stailus/SI4684-DAB-Receiver/Kicad/Mainboard SMD/SI4684 SMD.kicad_pcb

## KiCad design Kicad/Mainboard SMD/SI4684 SMD.kicad_pcb (2025-07-09)

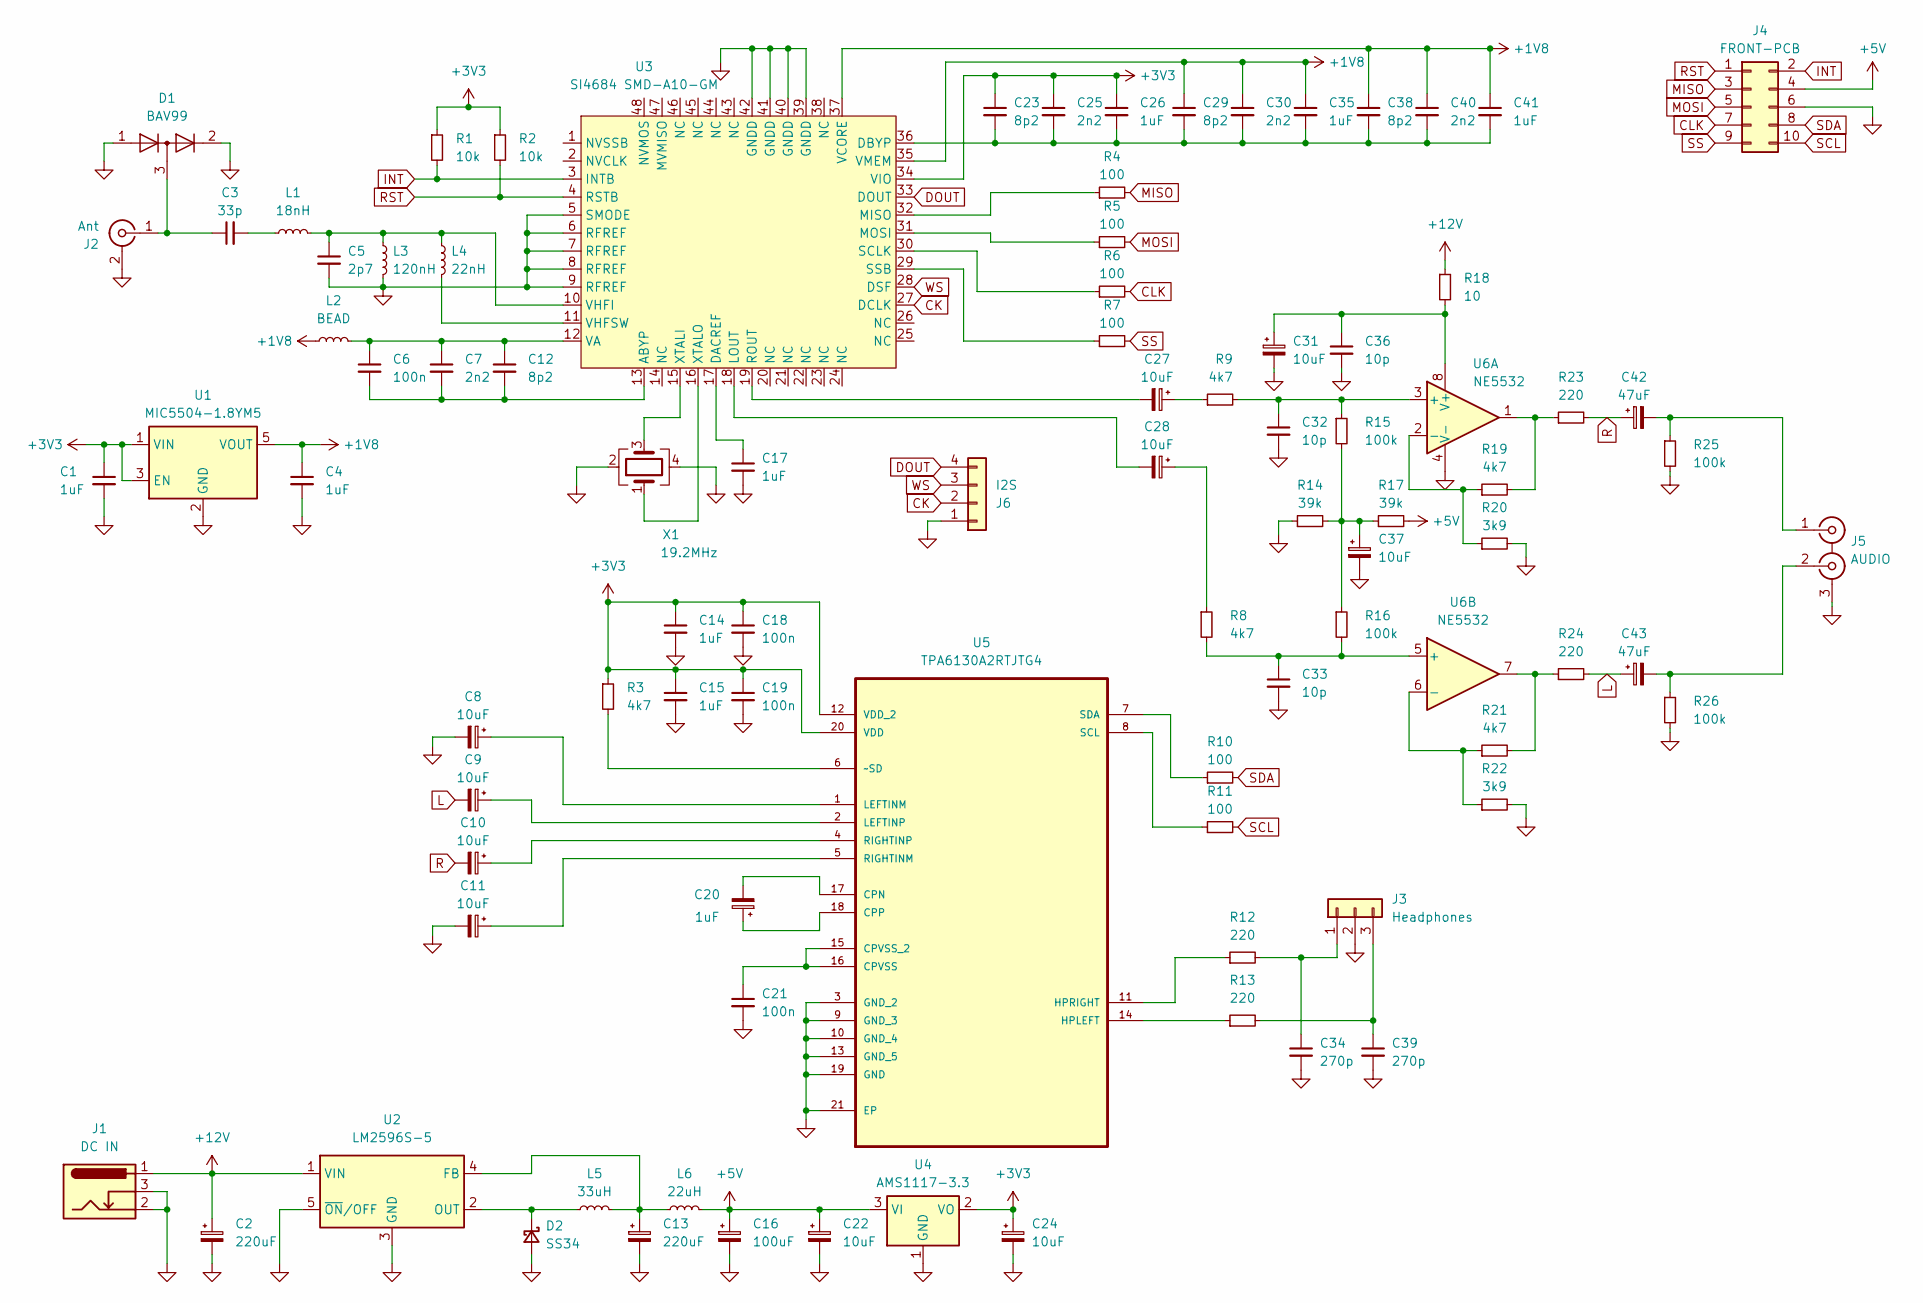
[picture p1: schematic SI4684 SMD.kicad_sch, SI4684 SMD DAB ontvanger]

Parts:
C1, C4, C14, C15, C17, C26, C35, C41: 1uF; C_0603_1608Metric
C2, C13: 220uF; CP_Elec_6.3x7.7
C3: 33p; C_0603_1608Metric
C5: 2p7; C_0603_1608Metric
C6, C18, C19, C21: 100n; C_0603_1608Metric
C7, C25, C30, C40: 2n2; C_0603_1608Metric
C8, C9, C10, C11, C22, C24, C27, C28, C31, C37: 10uF; CP_Elec_4x5.4
C12, C23, C29, C38: 8p2; C_0603_1608Metric
C16: 100uF; CP_Elec_6.3x7.7
C20: 1uF; CP_Elec_4x5.4
C32, C33, C36: 10p; C_0603_1608Metric
C34, C39: 270p; C_0603_1608Metric
C42, C43: 47uF; CP_Elec_6.3x5.4
D1: BAV99; SOT-23
D2: SS34; D_SMB
J1: DC IN; BarrelJack_Horizontal
J2: Ant; SMA_Amphenol_132134-16_Vertical
J3: Headphones; JST_PH_B3B-PH-K_1x03_P2.00mm_Vertical
J4: FRONT-PCB; IDC-Header_2x05_P2.54mm_Vertical
J5: AUDIO; FC68405_cinch
J6: I2S; PinHeader_1x04_P2.54mm_Vertical
L1: 18nH; L_0603_1608Metric
L2: BEAD; L_0603_1608Metric
L3: 120nH; L_0603_1608Metric
L4: 22nH; L_0603_1608Metric
L5: 33uH; L_TracoPower_TCK-047_5.2x5.8mm
L6: 22uH; L_TracoPower_TCK-047_5.2x5.8mm
R1, R2: 10k; R_0603_1608Metric
R3, R8, R9, R19, R21: 4k7; R_0603_1608Metric
R4, R5, R6, R7, R10, R11: 100; R_0603_1608Metric
R12, R13, R23, R24: 220; R_0603_1608Metric
R14, R17: 39k; R_0603_1608Metric
R15, R16, R25, R26: 100k; R_0603_1608Metric
R18: 10; R_0603_1608Metric
R20, R22: 3k9; R_0603_1608Metric
U1: MIC5504-1.8YM5; SOT-23-5
U2: LM2596S-5; TO-263-5_TabPin3
U3: SI4684 SMD-A10-GM; QFN-48-1EP_7x7mm_P0.5mm_EP5.3x5.3mm
U4: AMS1117-3.3; SOT-223-3_TabPin2
U5: TPA6130A2RTJTG4; QFN-20-1EP_4x4mm_P0.5mm_EP2.7x2.7mm; MPN TPA6130A2RTJTG4
U6: NE5532; SOIC-8_3.9x4.9mm_P1.27mm
X1: 19.2MHz; Crystal_SMD_3225-4Pin_3.2x2.5mm

Connections:
+1V8: C4.1, C29.1, C30.1, C35.1, C38.1, C40.1, C41.1, L2.1, U1.5 (VOUT), U3.35 (VMEM), U3.37 (VCORE)
+3V3: C1.1, C14.1, C15.1, C18.1, C19.1, C23.1, C24.1, C25.1, C26.1, R1.1, R2.1, R3.1, U1.1 (VIN), U1.3 (EN), U3.34 (VIO), U4.2 (VO), U5.12 (VDD_2), U5.20 (VDD)
+5V: C16.1, C22.1, J4.4, L6.2, R17.2, U4.3 (VI)
+12V: C2.1, J1.1, R18.1, U2.1 (VIN)
CK: J6.2, U3.27 (DCLK)
CLK: J4.7, R6.2
DOUT: J6.4, U3.33 (DOUT)
GND: C1.2, C2.2, C4.2, C5.2, C8.2, C11.2, C13.2, C14.2, C15.2, C16.2, C17.2, C18.2, C19.2, C21.2, C22.2, C24.2, C31.2, C32.2, C33.2, C34.2, C36.2, C37.2, C39.2, D1.1 (K), D1.2 (A), D2.2 (A), J1.2, J1.3, J2.2 (Ext), J3.2, J4.6, J5.3 (EXT), J6.1, L3.2, R14.1, R20.2, R22.2, R25.2, R26.2, U1.2 (GND), U2.3 (GND), U2.5 (~ON/OFF), U3.5 (SMODE), U3.6 (RFREF), U3.7 (RFREF), U3.8 (RFREF), U3.9 (RFREF), U3.39 (GNDD), U3.40 (GNDD), U3.41 (GNDD), U3.42 (GNDD), U3.49 (GND), U4.1 (GND), U5.3 (GND_2), U5.9 (GND_3), U5.10 (GND_4), U5.13 (GND_5), U5.19 (GND), U5.21 (EP), U6.4 (V-), X1.2, X1.4
INT: J4.2, R1.2, U3.3 (INTB)
L: C9.2, C43.1, R24.2
MISO: J4.3, R4.2
MOSI: J4.5, R5.2
unnamed: C3.2, L1.1
unnamed: C27.1, R9.1
unnamed: C28.1, R8.1
unnamed: C37.1, R14.2, R15.2, R16.1, R17.1
unnamed: D2.1 (K), L5.1, U2.2 (OUT)
unnamed: C3.1, D1.3 (K), J2.1 (In)
unnamed: C34.1, J3.1, R12.2
unnamed: C39.1, J3.3, R13.2
unnamed: C42.2, J5.1 (IN1), R25.1
unnamed: C43.2, J5.2 (IN2), R26.1
unnamed: R19.2, R23.1, U6.1
unnamed: R21.2, R24.1, U6.7
unnamed: C13.1, L5.2, L6.1, U2.4 (FB)
unnamed: C6.2, C7.2, C12.2, U3.13 (ABYP)
unnamed: C17.1, U3.17 (DACREF)
unnamed: C23.2, C25.2, C26.2, C29.2, C30.2, C35.2, C38.2, C40.2, C41.2, U3.36 (DBYP)
unnamed: C28.2, U3.18 (LOUT)
unnamed: R4.1, U3.32 (MISO)
unnamed: R5.1, U3.31 (MOSI)
unnamed: C27.2, U3.19 (ROUT)
unnamed: R6.1, U3.30 (SCLK)
unnamed: R7.1, U3.29 (SSB)
unnamed: C6.1, C7.1, C12.1, L2.2, U3.12 (VA)
unnamed: C5.1, L1.2, L3.1, L4.1, U3.10 (VHFI)
unnamed: L4.2, U3.11 (VHFSW)
unnamed: U3.15 (XTALI), X1.3
unnamed: U3.16 (XTALO), X1.1
unnamed: C20.2, U5.17 (CPN)
unnamed: C20.1, U5.18 (CPP)
unnamed: C21.1, U5.15 (CPVSS_2), U5.16 (CPVSS)
unnamed: R13.1, U5.14 (HPLEFT)
unnamed: R12.1, U5.11 (HPRIGHT)
unnamed: C8.1, U5.1 (LEFTINM)
unnamed: C9.1, U5.2 (LEFTINP)
unnamed: C11.1, U5.5 (RIGHTINM)
unnamed: C10.1, U5.4 (RIGHTINP)
unnamed: R11.1, U5.8 (SCL)
unnamed: R10.1, U5.7 (SDA)
unnamed: R3.2, U5.6 (~SD)
unnamed: C32.1, R9.2, R15.1, U6.3 (+)
unnamed: R19.1, R20.1, U6.2 (-)
unnamed: C33.1, R8.2, R16.2, U6.5 (+)
unnamed: R21.1, R22.1, U6.6 (-)
unnamed: C31.1, C36.1, R18.2, U6.8 (V+)
R: C10.2, C42.1, R23.2
RST: J4.1, R2.2, U3.4 (RSTB)
SCL: J4.10, R11.2
SDA: J4.8, R10.2
SS: J4.9, R7.2
WS: J6.3, U3.28 (DSF)

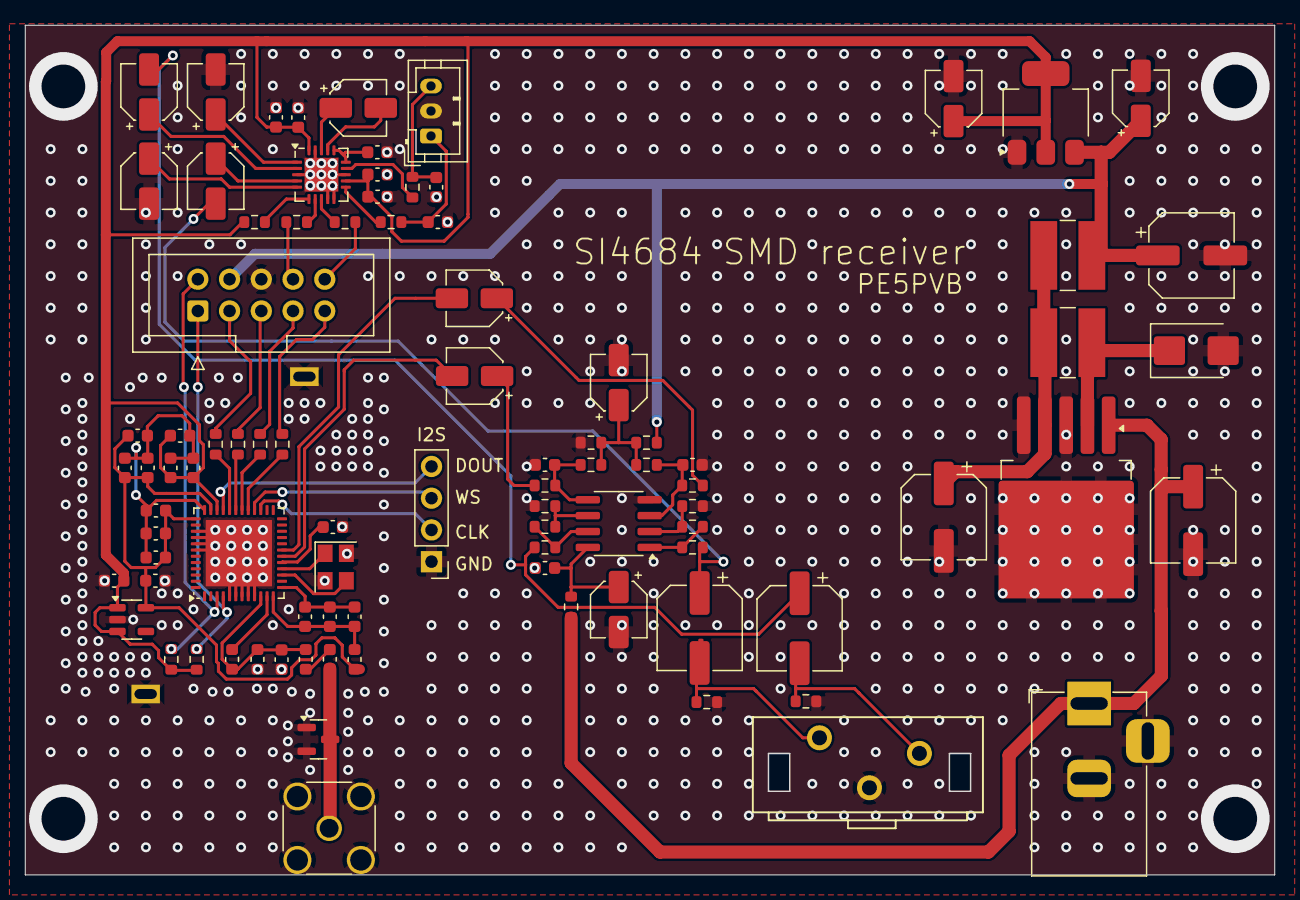
[picture p2: board SI4684 SMD.kicad_pcb from above]

Board: 2 copper layers, 100.0 x 68.0 mm, 90 parts (0 on the bottom side), 62 nets.
