stailus/SI4684-DAB-Receiver/(commit log)

2025-07-09 Added SMD board Kicad files
    [SI4684 SMD.kicad_pcb, SI4684 SMD.kicad_sch, SI4684 controller SMD.kicad_pcb, SI4684 controller SMD.kicad_sch]
2025-12-29 Fixed problem with compiling slideshow
    [slideshow.cpp]
2026-01-07 Fixed date/time detection
    Added Partitions file, choose "custom" when compiling with latest boardmanager
    [partitions.csv]
2026-01-15 Improvement of channellist parsing
    [partition_custom.csv]
2026-01-16 Faster assembly of slideshow images
2026-01-16 Update partitions file
    [partitions.csv]
2026-01-16 Removed tft_espi from API. Doesn't belong there
    [si4684.h]
2026-01-17 Fixed problem for compiling with Arduino IDE
    [main.cpp]
2026-01-24 Default volume value after reset should be 100%
    [SI4684-DAB-Receiver.ino]
2026-01-29 Fixed fading error on failing slideshow
    [slideshow.cpp]
2026-01-30 Progressive JPEG file-based decoding (before multi-scan attempt)
    - Added local JPEGDEC library with removed auto-scaling for progressive
    - Implemented file-based pixel storage to avoid RAM limitations
    - Adaptive scaling (HALF/QUARTER/EIGHTH) based on available memory
    - Bilinear interpolation for upscaling from temp file
    This is a savepoint before attempting full multi-scan progressive decoding.
    [slideshow.cpp, slideshow.h]
2026-02-09 Fix EID and Ensemblename when EID ends with 0
    [si4684.cpp]
2026-02-09 Fixed problem with ECC display
    [gui.cpp, si4684.cpp, si4684.h]
2026-02-09 Undo some buggy changes
    [SI4684-DAB-Receiver.ino, si4684.cpp, slideshow.h]
2026-02-11 Improved slideshow assembly speed
2026-02-14 Background of transparant PNG fixed
    [_test_png.py, comms.cpp, slideshow.cpp]
